Wavega-tx/Qwiic_GPS-RTK2/Hardware/Qwiic GPS-RTK2 - ublox ZED-F9P.brd

## EAGLE design Hardware/Qwiic GPS-RTK2 - ublox ZED-F9P.brd (2020-01-10)

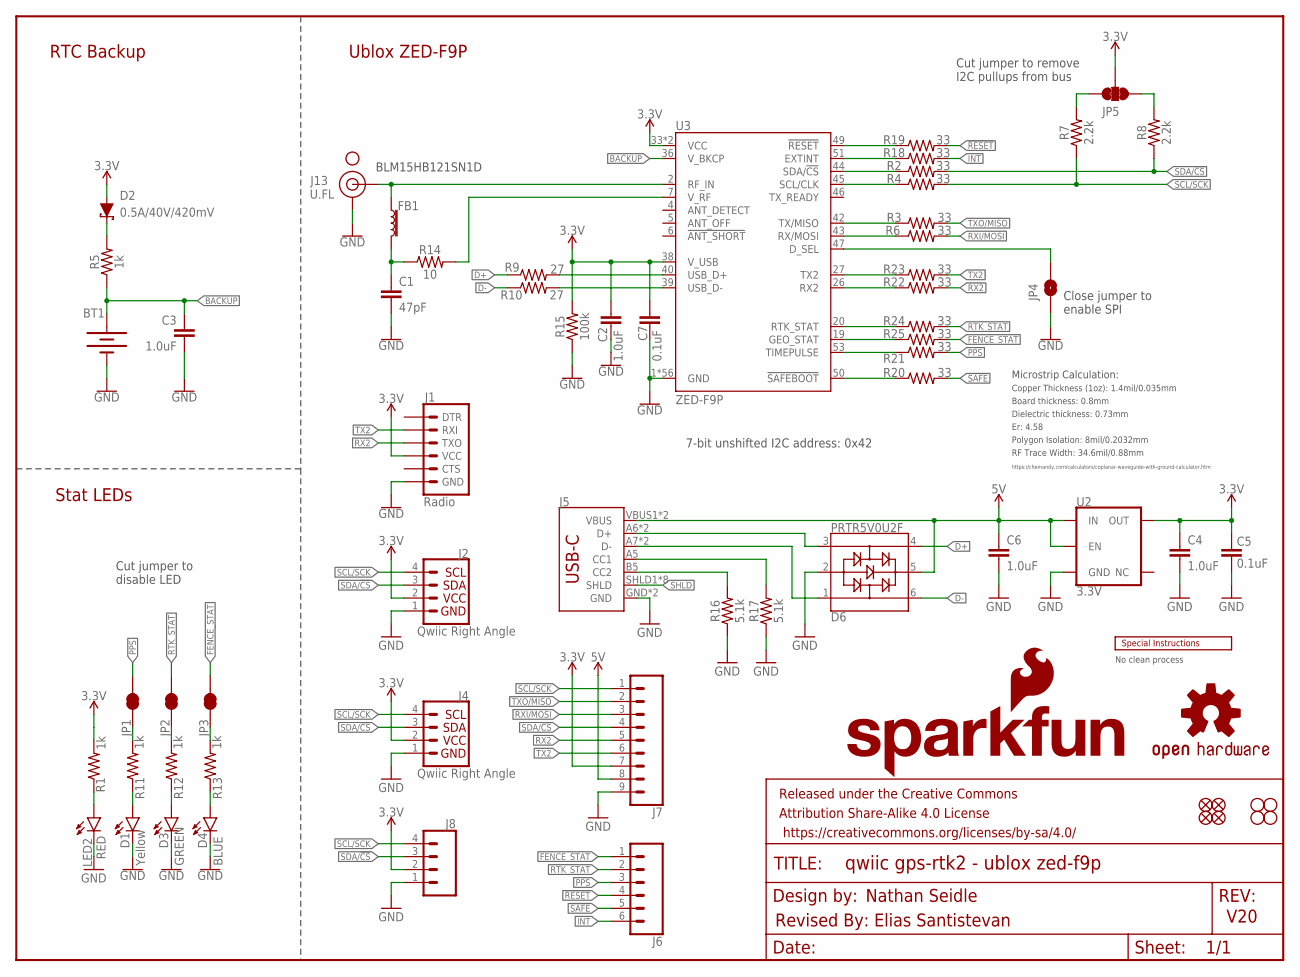
[picture p1: schematic Qwiic GPS-RTK2 - ublox ZED-F9P.sch]

Parts:
BT1: ML414H_IV01E_BATTERY; ML414H_IV01E
C1: 47pF; 0603
C2, C3, C4, C6: 1.0uF; 0603
C5, C7: 0.1uF; 0603
D1: Yellow; LED-0603
D2: 0.5A/40V/420mV; SOD-323
D3: GREEN; LED-0603
D4: BLUE; LED-0603
D6: PRTR5V0U2F; SOT886
FB1: FERRITE_BEAD-120_OHM-0402; 0402
FRAME1: FRAME-LETTER; CREATIVE_COMMONS
J1: Radio; 1X06_NO_SILK
J2, J4: Qwiic Right Angle; JST04_1MM_RA
J5: USB_C2-LAYER; USB-C-16P
J6: CONN_06NO_SILK_FEMALE_PTH; 1X06_NO_SILK
J7: CONN_09NO_SILK; 1X09_NO_SILK
J8: CONN_041X04_NO_SILK; 1X04_NO_SILK
J13: U.FL
JP1, JP2, JP3: JUMPER-SMT_2_NC_TRACE_SILK; SMT-JUMPER_2_NC_TRACE_SILK
JP4: JUMPER-SMT_2_NO_SILK; SMT-JUMPER_2_NO_SILK
JP5: JUMPER-SMT_3_2-NC_TRACE_SILK; SMT-JUMPER_3_2-NC_TRACE_SILK
JP21, JP61, JP71, JP81: FIDUCIALUFIDUCIAL; FIDUCIAL-MICRO
JP31, JP41, JP91, JP101: STAND-OFFTIGHT; STAND-OFF-TIGHT
LED2: RED; LED-0603
LOGO1: OSHW-LOGOMINI; OSHW-LOGO-MINI
LOGO2: SFE_LOGO_NAME_FLAME.1_INCH; SFE_LOGO_NAME_FLAME_.1
R1, R5, R11, R12, R13: 1k; 0603
R2, R3, R4, R6, R18, R19, R20, R21, R22, R23, R24, R25: 33; 0603
R7, R8: 2.2k; 0603
R9, R10: 27; 0603
R14: 10; 0603
R15: 100k; 0603
R16, R17: 5.1k; 0603
U2: 3.3V; SOT23-5
U3: ZED-F9P
U$2: SPECIAL_INSTRUCTIONS-ORDERING; ORDERING_INSTRUCTIONS
U$54: SMA-ANTENNA-THREADED; SMA-THREADED

Connections:
3.3V: C2.1, C4.1, C5.2, C7.2, D2.A, J1.4 (VCC), J2.2, J4.2, J7.7, J8.2, JP5.2, R1.2, R15.2, U2.5 (OUT), U3.33 (VCC), U3.34 (VCC), U3.38 (V_USB)
5V: C6.1, D6.5, J5.VBUS1 (VBUS), J5.VBUS2 (VBUS), J7.8, U2.1 (IN), U2.3 (EN)
!RESET: J6.4, R19.2
!SAFE: J6.5, R20.2
ANT_VCC: C1.1, FB1.2, R14.1
BACKUP: BT1.+, C3.1, R5.1, U3.36 (V_BKCP)
CC1: J5.A5 (CC1), R17.2
CC2: J5.B5 (CC2), R16.2
D+: D6.4, R9.1
D-: D6.6, R10.1
D_SEL: JP4.2, U3.47 (D_SEL)
FENCE_STAT: J6.1, JP3.2, R25.2
GND: BT1.-, C1.2, C2.2, C3.2, C4.2, C5.1, C6.2, C7.1, D1.C, D3.C, D4.C, D6.2, J1.6 (GND), J2.1, J4.1, J5.GND, J5.GND2 (GND), J7.9, J8.1, J13.1 (GND), J13.2 (GND), JP4.1, LED2.C, R15.1, R16.1, R17.1, U2.2 (GND), U3.1 (GND), U3.3 (GND), U3.12 (GND), U3.14 (GND), U3.32 (GND), U3.37 (GND), U3.41 (GND), U3.48 (GND), U3.55 (GND), U3.56 (GND), U3.57 (GND), U3.58 (GND), U3.59 (GND), U3.60 (GND), U3.61 (GND), U3.62 (GND), U3.63 (GND), U3.64 (GND), U3.65 (GND), U3.66 (GND), U3.67 (GND), U3.68 (GND), U3.69 (GND), U3.70 (GND), U3.71 (GND), U3.72 (GND), U3.73 (GND), U3.74 (GND), U3.75 (GND), U3.76 (GND), U3.77 (GND), U3.78 (GND), U3.79 (GND), U3.80 (GND), U3.81 (GND), U3.82 (GND), U3.83 (GND), U3.84 (GND), U3.85 (GND), U3.86 (GND), U3.87 (GND), U3.88 (GND), U3.89 (GND), U3.90 (GND), U3.91 (GND), U3.92 (GND), U3.93 (GND), U3.94 (GND), U3.95 (GND), U3.96 (GND), U3.97 (GND), U3.98 (GND), U3.99 (GND), U3.100 (GND), U3.101 (GND), U3.102 (GND)
GPS_ANT1: FB1.1, J13.FEED (SIGNAL), U3.2 (RF_IN)
INT: J6.6, R18.2
unnamed: D3.A, R12.1
unnamed: D1.A, R11.1
unnamed: JP2.1, R12.2
unnamed: JP1.1, R11.2
unnamed: JP5.1, R8.2
unnamed: D2.C, R5.2
unnamed: D4.A, R13.1
unnamed: JP5.3, R7.2
unnamed: JP3.1, R13.2
unnamed: LED2.A, R1.1
unnamed: R9.2, U3.40 (USB_D+)
unnamed: R10.2, U3.39 (USB_D-)
unnamed: R14.2, U3.7 (V_RF)
unnamed: R22.1, U3.26 (RX2)
unnamed: R18.1, U3.51 (EXTINT)
unnamed: R19.1, U3.49 (!RESET!)
unnamed: R21.1, U3.53 (TIMEPULSE)
unnamed: R20.1, U3.50 (!SAFEBOOT!)
unnamed: R24.1, U3.20 (RTK_STAT)
unnamed: R25.1, U3.19 (GEO_STAT)
PPS: J6.3, JP1.2, R21.2
RTK_STAT: J6.2, JP2.2, R24.2
RX2: J1.3 (TXO), J7.5, R22.2
RXI/MOSI: J7.3, R6.2
RXLV: R6.1, U3.43 (RX/MOSI)
SCL/SCK: J2.4, J4.4, J7.1, J8.4, R4.2, R7.1
SCL_LV: R4.1, U3.45 (SCL/CLK)
SDA/!CS: J2.3, J4.3, J7.4, J8.3, R2.2, R8.1
SDA_LV: R2.1, U3.44 (SDA/!CS!)
SHLD: J5.SHLD1 (SHLD), J5.SHLD2 (SHLD), J5.SHLD3 (SHLD), J5.SHLD4 (SHLD), J5.SHLD5 (SHLD), J5.SHLD6 (SHLD), J5.SHLD7 (SHLD), J5.SHLD8 (SHLD)
TX2: J1.2 (RXI), J7.6, R23.2
TX2_P: R23.1, U3.27 (TX2)
TXLV: R3.1, U3.42 (TX/MISO)
TXO/MISO: J7.2, R3.2
UNP_D+: D6.3, J5.A6 (D+), J5.B6 (D+)
UNP_D-: D6.1, J5.A7 (D-), J5.B7 (D-)

Notes on the sheet:
V20
7-bit unshifted I2C address: 0x42
Ublox ZED-F9P
RTC Backup
Stat LEDs
Cut jumper to remove I2C pullups from bus
Cut jumper to disable LED
Close jumper to enable SPI
BLM15HB121SN1D
Board thickness: 0.8mm
Er: 4.58
Copper Thickness (1oz): 1.4mil/0.035mm
RF Trace Width: 34.6mil/0.88mm
Polygon Isolation: 8mil/0.2032mm
No clean process
Dielectric thickness: 0.73mm
https://chemandy.com/calculators/coplanar-waveguide-with-ground-calculator.htm
Microstrip Calculation:
Nathan Seidle
Revised By: Elias Santistevan

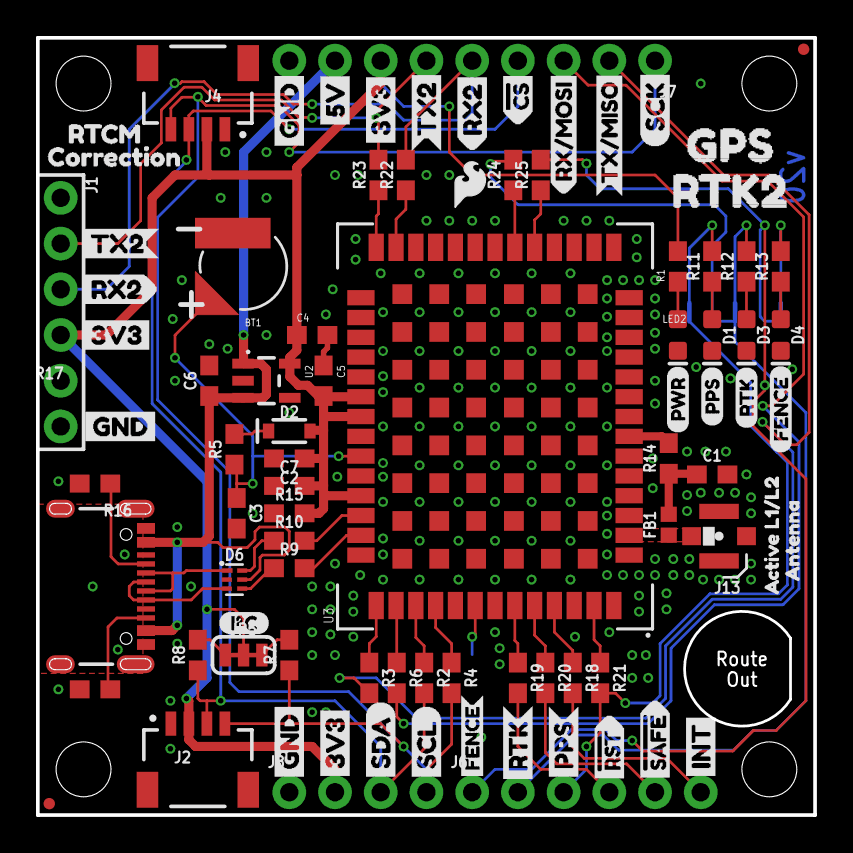
[picture p2: board Qwiic GPS-RTK2 - ublox ZED-F9P.brd from above]

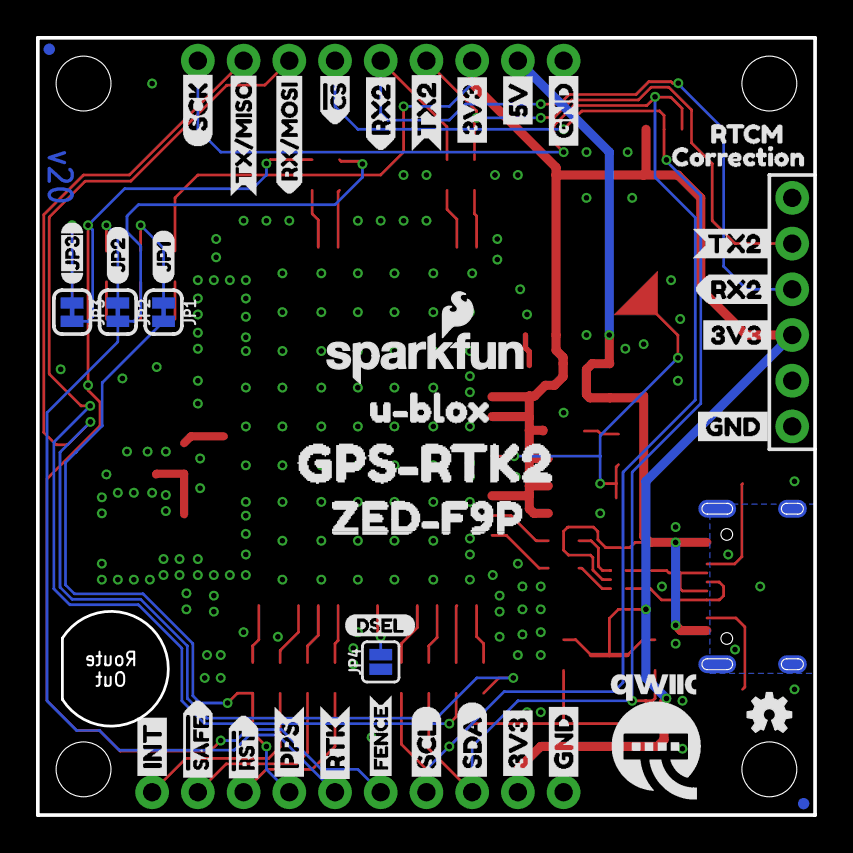
[picture p3: board Qwiic GPS-RTK2 - ublox ZED-F9P.brd from below]

Board: 2 copper layers, 43.2 x 43.2 mm, 136 parts (41 on the bottom side), 51 nets.

Other parts of the board:
U$1, U$4: SDA-[)
U$3, U$5: SCL-[)
U$6, U$7, U$60, U$61, U$66, U$67: 3V3-04
U$8, U$9, U$62, U$63: GND-04
U$10: I_SUPER2_C-()-03
U$11: FENCE2
U$12: JP20
U$13, U$28, U$29: RTK1
U$14, U$17: FENCE0
U$15, U$16: INT8
U$18: PWR-()-03
U$19, U$20: 5V
U$21, U$56, U$58: RX20
U$22: U#BLOX3
U$23, U$24: CS#-<]
U$25: JP10
U$26, U$31: RX#MOSI3
U$27: DSEL0
U$30: QWIIC-LOGO-MEDIUM
U$32: JP32
U$33: SFE_LOGO_FLAME_.1
U$34, U$37: TX#MISO1
U$35, U$36: #RST3
U$38, U$41: SCK-(]-04
U$39, U$40: #SAFE1
U$42: RX22
U$43, U$44: PPS5
U$45, U$68: GND3
U$46: GPS#RTK28
U$48, U$70: RTCM5
U$49: ZED#F9P6
U$50, U$55, U$57: TX21
U$51: TX23
U$52: PPS0
U$53, U$69: CORRECTION0
U$59: GPS0
U$64: RTK21
U$65: ACTIVE_L1#L21
U$71: ANTENNA2
