Wavega-tx/Qwiic_GPS-RTK2/Hardware/Production/Qwiic GPS-RTK2 - ublox ZED-F9P-Panel.brd

## EAGLE design Hardware/Production/Qwiic GPS-RTK2 - ublox ZED-F9P-Panel.brd (2020-01-10)

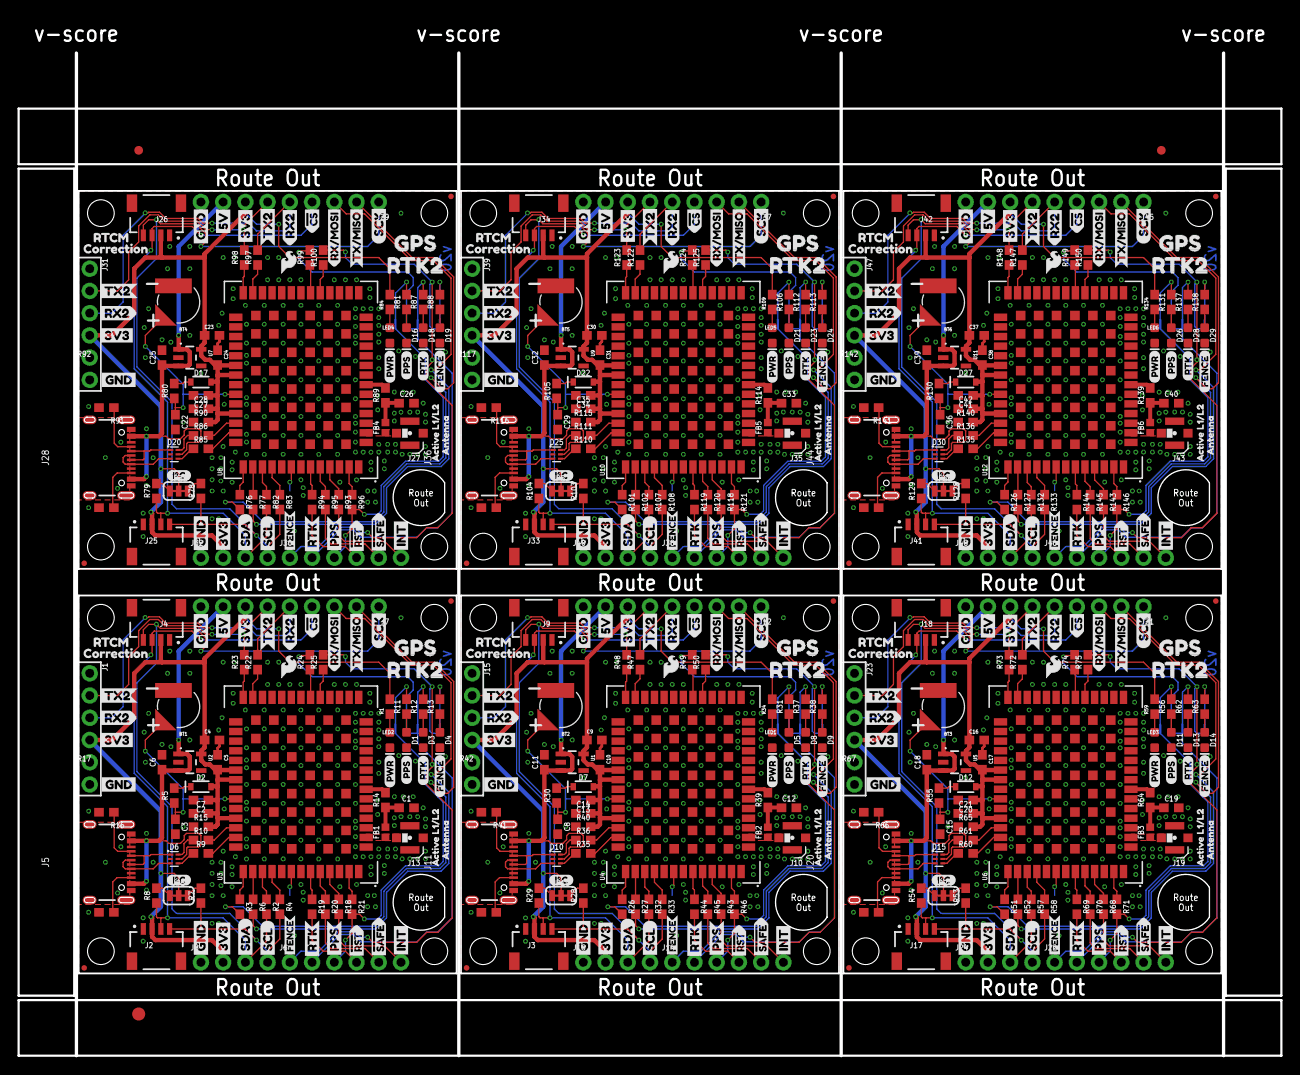
[picture p4: board Qwiic GPS-RTK2 - ublox ZED-F9P-Panel.brd from above]

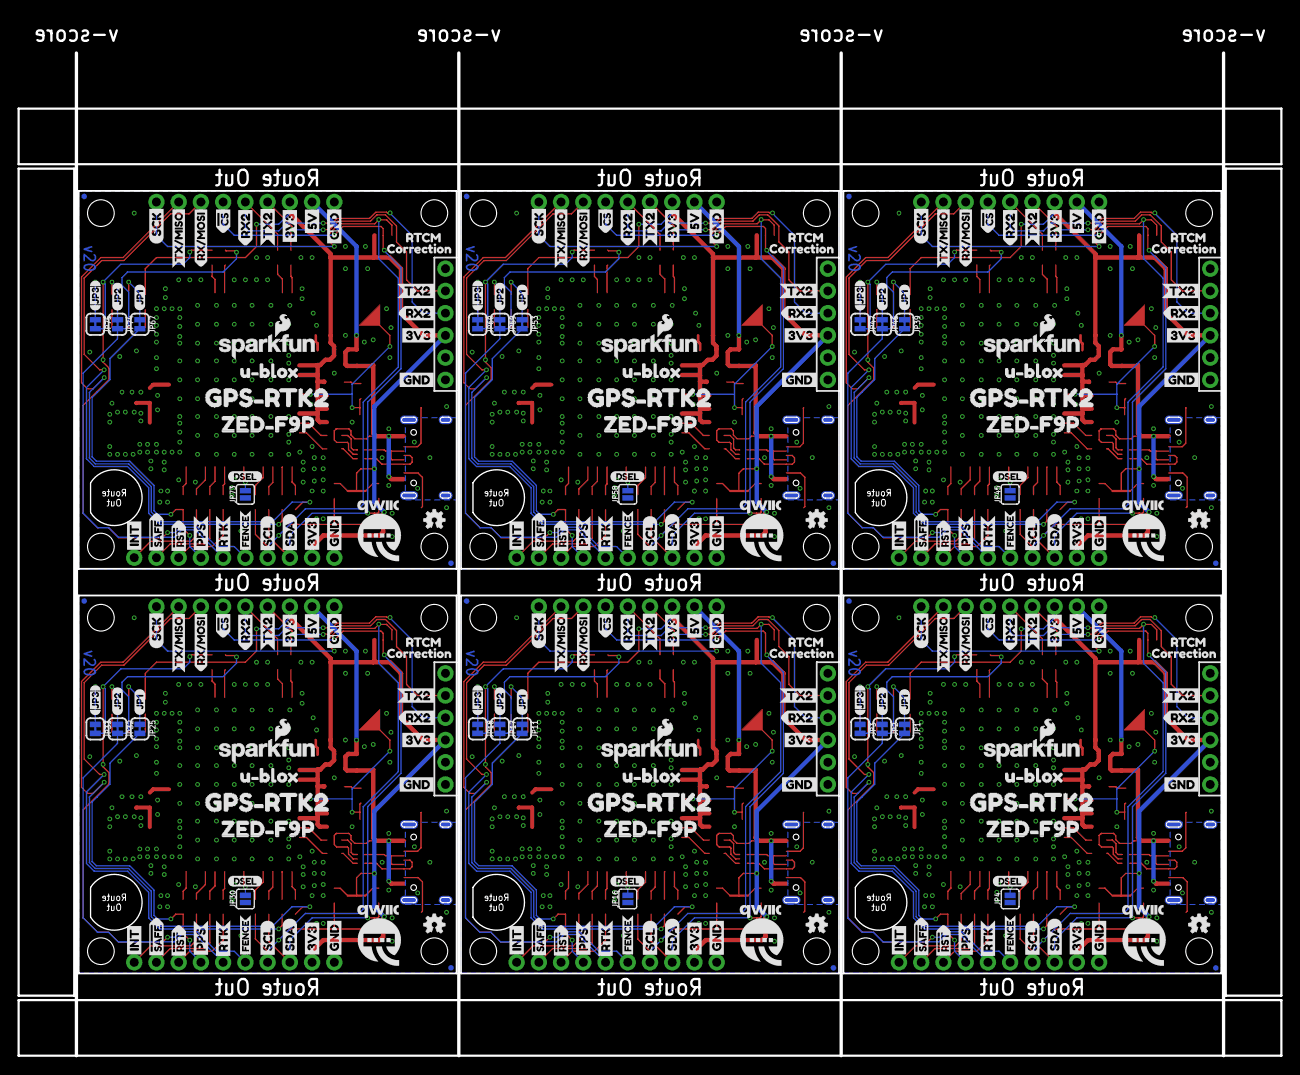
[picture p5: board Qwiic GPS-RTK2 - ublox ZED-F9P-Panel.brd from below]

Board: 2 copper layers, 144.3 x 114.6 mm, 807 parts (246 on the bottom side), 306 nets.

Parts:
BT1, BT2, BT3, BT4, BT5, BT6: ML414H_IV01E_BATTERY; ML414H_IV01E
C1, C12, C19, C26, C33, C40: 47pF; 0603
C2, C3, C4, C6, C8, C9, C11, C13, C15, C16, C18, C20, C22, C23, C25, C27, C29, C30, C32, C34, C36, C37, C39, C41: 1.0uF; 0603
C5, C7, C10, C14, C17, C21, C24, C28, C31, C35, C38, C42: 0.1uF; 0603
D1, D5, D11, D16, D21, D26: Yellow; LED-0603
D2, D7, D12, D17, D22, D27: 0.5A/40V/420mV; SOD-323
D3, D8, D13, D18, D23, D28: GREEN; LED-0603
D4, D9, D14, D19, D24, D29: BLUE; LED-0603
D6, D10, D15, D20, D25, D30: PRTR5V0U2F; SOT886
E$1, E$2: FIDUCIAL-1X2
E$3: FIDUCIAL-1.5X3
FB1, FB2, FB3, FB4, FB5, FB6: FERRITE_BEAD-120_OHM-0402; 0402
J1, J15, J23, J31, J39, J47: Radio; 1X06_NO_SILK
J2, J3, J4, J9, J17, J18, J25, J26, J33, J34, J41, J42: Qwiic Right Angle; JST04_1MM_RA
J5, J11, J20, J28, J36, J44: USB-C-16P
J6, J14, J22, J30, J38, J46: 1X06_NO_SILK
J7, J12, J21, J29, J37, J45: 1X09_NO_SILK
J8, J16, J24, J32, J40, J48: 1X04_NO_SILK
J10, J13, J19, J27, J35, J43: U.FL
JP1, JP2, JP3, JP11, JP17, JP18, JP25, JP32, JP33, JP39, JP46, JP47, JP53, JP59, JP60, JP67, JP74, JP75: JUMPER-SMT_2_NC_TRACE_SILK; SMT-JUMPER_2_NC_TRACE_SILK
JP4, JP16, JP30, JP45, JP58, JP73: JUMPER-SMT_2_NO_SILK; SMT-JUMPER_2_NO_SILK
JP5, JP10, JP24, JP38, JP52, JP66: JUMPER-SMT_3_2-NC_TRACE_SILK; SMT-JUMPER_3_2-NC_TRACE_SILK
JP6, JP7, JP14, JP15, JP19, JP20, JP28, JP29, JP31, JP34, JP35, JP41, JP43, JP44, JP48, JP49, JP56, JP57, JP62, JP63, JP70, JP72, JP91, JP101: STAND-OFFTIGHT; STAND-OFF-TIGHT
JP8, JP9, JP12, JP13, JP21, JP22, JP23, JP26, JP27, JP36, JP37, JP40, JP42, JP50, JP51, JP54, JP55, JP61, JP64, JP65, JP68, JP69, JP71, JP81: FIDUCIALUFIDUCIAL; FIDUCIAL-MICRO
LED1, LED2, LED3, LED4, LED5, LED6: RED; LED-0603
LOGO1, LOGO3, LOGO5, LOGO7, LOGO9, LOGO11: OSHW-LOGOMINI; OSHW-LOGO-MINI
LOGO2, LOGO4, LOGO6, LOGO8, LOGO10, LOGO12: SFE_LOGO_NAME_FLAME.1_INCH; SFE_LOGO_NAME_FLAME_.1
R1, R5, R11, R12, R13, R30, R31, R34, R37, R38, R55, R56, R59, R62, R63, R80, R81, R84, R87, R88, R105, R106, R109, R112, R113, R130, R131, R134, R137, R138: 1k; 0603
R2, R3, R4, R6, R18, R19, R20, R21, R22, R23, R24, R25, R26, R27, R32, R33, R43, R44, R45, R46, R47, R48, R49, R50, R51, R52, R57, R58, R68, R69, R70, R71, R72, R73, R74, R75, R76, R77, R82, R83, R93, R94, R95, R96, R97, R98, R99, R100, R101, R102, R107, R108, R118, R119, R120, R121, R122, R123, R124, R125, R126, R127, R132, R133, R143, R144, R145, R146, R147, R148, R149, R150: 33; 0603
R7, R8, R28, R29, R53, R54, R78, R79, R103, R104, R128, R129: 2.2k; 0603
R9, R10, R35, R36, R60, R61, R85, R86, R110, R111, R135, R136: 27; 0603
R14, R39, R64, R89, R114, R139: 10; 0603
R15, R40, R65, R90, R115, R140: 100k; 0603
R16, R17, R41, R42, R66, R67, R91, R92, R116, R117, R141, R142: 5.1k; 0603
U1, U2, U5, U7, U9, U11: 3.3V; SOT23-5
U3, U4, U6, U8, U10, U12: ZED-F9P
U$1, U$2, U$4, U$72, U$139, U$141, U$208, U$210, U$277, U$279, U$346, U$348: SDA-[)
U$3, U$5, U$47, U$73, U$140, U$142, U$209, U$211, U$278, U$280, U$347, U$349: SCL-[)
U$6, U$7, U$60, U$61, U$66, U$67, U$74, U$75, U$97, U$98, U$116, U$117, U$143, U$144, U$166, U$167, U$185, U$186, U$212, U$213, U$235, U$236, U$254, U$255, U$281, U$282, U$304, U$305, U$323, U$324, U$350, U$351, U$373, U$374, U$392, U$393: 3V3-04
U$8, U$9, U$62, U$63, U$76, U$77, U$99, U$100, U$145, U$146, U$168, U$169, U$214, U$215, U$237, U$238, U$283, U$284, U$306, U$307, U$352, U$353, U$375, U$376: GND-04
U$10, U$78, U$147, U$216, U$285, U$354: I_SUPER2_C-()-03
U$11, U$90, U$159, U$228, U$297, U$366: FENCE2
U$12, U$91, U$160, U$229, U$298, U$367: JP20
U$13, U$28, U$29, U$92, U$95, U$96, U$161, U$164, U$165, U$230, U$233, U$234, U$299, U$302, U$303, U$368, U$371, U$372: RTK1
U$14, U$17, U$93, U$94, U$162, U$163, U$231, U$232, U$300, U$301, U$369, U$370: FENCE0
U$15, U$16, U$79, U$80, U$148, U$149, U$217, U$218, U$286, U$287, U$355, U$356: INT8
U$18, U$104, U$173, U$242, U$311, U$380: PWR-()-03
U$19, U$20, U$105, U$106, U$174, U$175, U$243, U$244, U$312, U$313, U$381, U$382: 5V
U$21, U$56, U$58, U$129, U$134, U$136, U$198, U$203, U$205, U$267, U$272, U$274, U$336, U$341, U$343, U$405, U$410, U$412: RX20
U$22, U$81, U$150, U$219, U$288, U$357: U#BLOX3
U$23, U$24, U$107, U$108, U$176, U$177, U$245, U$246, U$314, U$315, U$383, U$384: CS#-<]
U$25, U$101, U$170, U$239, U$308, U$377: JP10
U$26, U$31, U$112, U$124, U$181, U$193, U$250, U$262, U$319, U$331, U$388, U$400: RX#MOSI3
U$27, U$103, U$172, U$241, U$310, U$379: DSEL0
U$30, U$82, U$151, U$220, U$289, U$358: QWIIC-LOGO-MEDIUM
U$32, U$102, U$171, U$240, U$309, U$378: JP32
U$33, U$111, U$180, U$249, U$318, U$387: SFE_LOGO_FLAME_.1
U$34, U$37, U$113, U$125, U$182, U$194, U$251, U$263, U$320, U$332, U$389, U$401: TX#MISO1
U$35, U$36, U$83, U$84, U$152, U$153, U$221, U$222, U$290, U$291, U$359, U$360: #RST3
U$38, U$41, U$109, U$110, U$178, U$179, U$247, U$248, U$316, U$317, U$385, U$386: SCK-(]-04
U$39, U$40, U$85, U$86, U$154, U$155, U$223, U$224, U$292, U$293, U$361, U$362: #SAFE1
U$42, U$130, U$199, U$268, U$337, U$406: RX22
U$43, U$44, U$87, U$88, U$156, U$157, U$225, U$226, U$294, U$295, U$363, U$364: PPS5
U$45, U$68, U$114, U$118, U$183, U$187, U$252, U$256, U$321, U$325, U$390, U$394: GND3
U$46, U$115, U$184, U$253, U$322, U$391: GPS#RTK28
U$48, U$70, U$120, U$122, U$189, U$191, U$258, U$260, U$327, U$329, U$396, U$398: RTCM5
U$49, U$121, U$190, U$259, U$328, U$397: ZED#F9P6
U$50, U$55, U$57, U$131, U$133, U$135, U$200, U$202, U$204, U$269, U$271, U$273, U$338, U$340, U$342, U$407, U$409, U$411: TX21
U$51, U$132, U$201, U$270, U$339, U$408: TX23
U$52, U$89, U$158, U$227, U$296, U$365: PPS0
U$53, U$69, U$119, U$123, U$188, U$192, U$257, U$261, U$326, U$330, U$395, U$399: CORRECTION0
U$54, U$126, U$195, U$264, U$333, U$402: SMA-ANTENNA-THREADED; SMA-THREADED
U$59, U$137, U$206, U$275, U$344, U$413: GPS0
U$64, U$138, U$207, U$276, U$345, U$414: RTK21
U$65, U$127, U$196, U$265, U$334, U$403: ACTIVE_L1#L21
U$71, U$128, U$197, U$266, U$335, U$404: ANTENNA2

Connections:
3.3V: C2.1, C4.1, C5.2, C7.2, D2.A, J1.4, J2.2, J4.2, J7.7, J8.2, JP5.2, R1.2, R15.2, U2.5, U3.33, U3.34, U3.38
3.3V1: C9.1, C10.2, C13.1, C14.2, D7.A, J3.2, J9.2, J12.7, J15.4, J16.2, JP10.2, R34.2, R40.2, U1.5, U4.33, U4.34, U4.38
3.3V2: C16.1, C17.2, C20.1, C21.2, D12.A, J17.2, J18.2, J21.7, J23.4, J24.2, JP24.2, R59.2, R65.2, U5.5, U6.33, U6.34, U6.38
3.3V3: C23.1, C24.2, C27.1, C28.2, D17.A, J25.2, J26.2, J29.7, J31.4, J32.2, JP38.2, R84.2, R90.2, U7.5, U8.33, U8.34, U8.38
3.3V4: C30.1, C31.2, C34.1, C35.2, D22.A, J33.2, J34.2, J37.7, J39.4, J40.2, JP52.2, R109.2, R115.2, U9.5, U10.33, U10.34, U10.38
3.3V5: C37.1, C38.2, C41.1, C42.2, D27.A, J41.2, J42.2, J45.7, J47.4, J48.2, JP66.2, R134.2, R140.2, U11.5, U12.33, U12.34, U12.38
5V: C6.1, D6.5, J5.VBUS1, J5.VBUS2, J7.8, U2.1, U2.3
5V1: C11.1, D10.5, J11.VBUS1, J11.VBUS2, J12.8, U1.1, U1.3
5V2: C18.1, D15.5, J20.VBUS1, J20.VBUS2, J21.8, U5.1, U5.3
5V3: C25.1, D20.5, J28.VBUS1, J28.VBUS2, J29.8, U7.1, U7.3
5V4: C32.1, D25.5, J36.VBUS1, J36.VBUS2, J37.8, U9.1, U9.3
5V5: C39.1, D30.5, J44.VBUS1, J44.VBUS2, J45.8, U11.1, U11.3
!RESET: J6.4, R19.2
!RESET1: J14.4, R44.2
!RESET2: J22.4, R69.2
!RESET3: J30.4, R94.2
!RESET4: J38.4, R119.2
!RESET5: J46.4, R144.2
!SAFE: J6.5, R20.2
!SAFE1: J14.5, R45.2
!SAFE2: J22.5, R70.2
!SAFE3: J30.5, R95.2
!SAFE4: J38.5, R120.2
!SAFE5: J46.5, R145.2
ANT_VCC: C1.1, FB1.2, R14.1
ANT_VCC1: C12.1, FB2.2, R39.1
ANT_VCC2: C19.1, FB3.2, R64.1
ANT_VCC3: C26.1, FB4.2, R89.1
ANT_VCC4: C33.1, FB5.2, R114.1
ANT_VCC5: C40.1, FB6.2, R139.1
BACKUP: BT1.+, C3.1, R5.1, U3.36
BACKUP1: BT2.+, C8.1, R30.1, U4.36
BACKUP2: BT3.+, C15.1, R55.1, U6.36
BACKUP3: BT4.+, C22.1, R80.1, U8.36
BACKUP4: BT5.+, C29.1, R105.1, U10.36
BACKUP5: BT6.+, C36.1, R130.1, U12.36
CC1: J5.A5, R17.2
CC2: J5.B5, R16.2
CC3: J11.A5, R42.2
CC4: J11.B5, R41.2
CC5: J20.A5, R67.2
CC6: J20.B5, R66.2
CC7: J28.A5, R92.2
CC8: J28.B5, R91.2
CC9: J36.A5, R117.2
CC10: J36.B5, R116.2
CC11: J44.A5, R142.2
CC12: J44.B5, R141.2
D+: D6.4, R9.1
D+1: D10.4, R35.1
D+2: D15.4, R60.1
D+3: D20.4, R85.1
D+4: D25.4, R110.1
D+5: D30.4, R135.1
D-: D6.6, R10.1
D-1: D10.6, R36.1
D-2: D15.6, R61.1
D-3: D20.6, R86.1
D-4: D25.6, R111.1
D-5: D30.6, R136.1
D_SEL: JP4.2, U3.47
D_SEL1: JP16.2, U4.47
D_SEL2: JP30.2, U6.47
D_SEL3: JP45.2, U8.47
D_SEL4: JP58.2, U10.47
D_SEL5: JP73.2, U12.47
FENCE_STAT: J6.1, JP3.2, R25.2
FENCE_STAT1: J14.1, JP18.2, R50.2
FENCE_STAT2: J22.1, JP33.2, R75.2
FENCE_STAT3: J30.1, JP47.2, R100.2
FENCE_STAT4: J38.1, JP60.2, R125.2
FENCE_STAT5: J46.1, JP75.2, R150.2
GND: BT1.-, C1.2, C2.2, C3.2, C4.2, C5.1, C6.2, C7.1, D1.C, D3.C, D4.C, D6.2, J1.6, J2.1, J4.1, J5.GND, J5.GND2, J7.9, J8.1, J13.1, J13.2, JP4.1, LED2.C, R15.1, R16.1, R17.1, U2.2, U3.1, U3.3, U3.12, U3.14, U3.32, U3.37, U3.41, U3.48, U3.55, U3.56, U3.57, U3.58, U3.59, U3.60, U3.61, U3.62, U3.63, U3.64, U3.65, U3.66, U3.67, U3.68, U3.69, U3.70, U3.71, U3.72, U3.73, U3.74, U3.75, U3.76, U3.77, U3.78, U3.79, U3.80, U3.81, U3.82, U3.83, U3.84, U3.85, U3.86, U3.87, U3.88, U3.89, U3.90, U3.91, U3.92, U3.93, U3.94, U3.95, U3.96, U3.97, U3.98, U3.99, U3.100, U3.101, U3.102
GND1: BT2.-, C8.2, C9.2, C10.1, C11.2, C12.2, C13.2, C14.1, D5.C, D8.C, D9.C, D10.2, J3.1, J9.1, J10.1, J10.2, J11.GND, J11.GND2, J12.9, J15.6, J16.1, JP16.1, LED1.C, R40.1, R41.1, R42.1, U1.2, U4.1, U4.3, U4.12, U4.14, U4.32, U4.37, U4.41, U4.48, U4.55, U4.56, U4.57, U4.58, U4.59, U4.60, U4.61, U4.62, U4.63, U4.64, U4.65, U4.66, U4.67, U4.68, U4.69, U4.70, U4.71, U4.72, U4.73, U4.74, U4.75, U4.76, U4.77, U4.78, U4.79, U4.80, U4.81, U4.82, U4.83, U4.84, U4.85, U4.86, U4.87, U4.88, U4.89, U4.90, U4.91, U4.92, U4.93, U4.94, U4.95, U4.96, U4.97, U4.98, U4.99, U4.100, U4.101, U4.102
GND2: BT3.-, C15.2, C16.2, C17.1, C18.2, C19.2, C20.2, C21.1, D11.C, D13.C, D14.C, D15.2, J17.1, J18.1, J19.1, J19.2, J20.GND, J20.GND2, J21.9, J23.6, J24.1, JP30.1, LED3.C, R65.1, R66.1, R67.1, U5.2, U6.1, U6.3, U6.12, U6.14, U6.32, U6.37, U6.41, U6.48, U6.55, U6.56, U6.57, U6.58, U6.59, U6.60, U6.61, U6.62, U6.63, U6.64, U6.65, U6.66, U6.67, U6.68, U6.69, U6.70, U6.71, U6.72, U6.73, U6.74, U6.75, U6.76, U6.77, U6.78, U6.79, U6.80, U6.81, U6.82, U6.83, U6.84, U6.85, U6.86, U6.87, U6.88, U6.89, U6.90, U6.91, U6.92, U6.93, U6.94, U6.95, U6.96, U6.97, U6.98, U6.99, U6.100, U6.101, U6.102
GND3: BT4.-, C22.2, C23.2, C24.1, C25.2, C26.2, C27.2, C28.1, D16.C, D18.C, D19.C, D20.2, J25.1, J26.1, J27.1, J27.2, J28.GND, J28.GND2, J29.9, J31.6, J32.1, JP45.1, LED4.C, R90.1, R91.1, R92.1, U7.2, U8.1, U8.3, U8.12, U8.14, U8.32, U8.37, U8.41, U8.48, U8.55, U8.56, U8.57, U8.58, U8.59, U8.60, U8.61, U8.62, U8.63, U8.64, U8.65, U8.66, U8.67, U8.68, U8.69, U8.70, U8.71, U8.72, U8.73, U8.74, U8.75, U8.76, U8.77, U8.78, U8.79, U8.80, U8.81, U8.82, U8.83, U8.84, U8.85, U8.86, U8.87, U8.88, U8.89, U8.90, U8.91, U8.92, U8.93, U8.94, U8.95, U8.96, U8.97, U8.98, U8.99, U8.100, U8.101, U8.102
GND4: BT5.-, C29.2, C30.2, C31.1, C32.2, C33.2, C34.2, C35.1, D21.C, D23.C, D24.C, D25.2, J33.1, J34.1, J35.1, J35.2, J36.GND, J36.GND2, J37.9, J39.6, J40.1, JP58.1, LED5.C, R115.1, R116.1, R117.1, U9.2, U10.1, U10.3, U10.12, U10.14, U10.32, U10.37, U10.41, U10.48, U10.55, U10.56, U10.57, U10.58, U10.59, U10.60, U10.61, U10.62, U10.63, U10.64, U10.65, U10.66, U10.67, U10.68, U10.69, U10.70, U10.71, U10.72, U10.73, U10.74, U10.75, U10.76, U10.77, U10.78, U10.79, U10.80, U10.81, U10.82, U10.83, U10.84, U10.85, U10.86, U10.87, U10.88, U10.89, U10.90, U10.91, U10.92, U10.93, U10.94, U10.95, U10.96, U10.97, U10.98, U10.99, U10.100, U10.101, U10.102
GND5: BT6.-, C36.2, C37.2, C38.1, C39.2, C40.2, C41.2, C42.1, D26.C, D28.C, D29.C, D30.2, J41.1, J42.1, J43.1, J43.2, J44.GND, J44.GND2, J45.9, J47.6, J48.1, JP73.1, LED6.C, R140.1, R141.1, R142.1, U11.2, U12.1, U12.3, U12.12, U12.14, U12.32, U12.37, U12.41, U12.48, U12.55, U12.56, U12.57, U12.58, U12.59, U12.60, U12.61, U12.62, U12.63, U12.64, U12.65, U12.66, U12.67, U12.68, U12.69, U12.70, U12.71, U12.72, U12.73, U12.74, U12.75, U12.76, U12.77, U12.78, U12.79, U12.80, U12.81, U12.82, U12.83, U12.84, U12.85, U12.86, U12.87, U12.88, U12.89, U12.90, U12.91, U12.92, U12.93, U12.94, U12.95, U12.96, U12.97, U12.98, U12.99, U12.100, U12.101, U12.102
GPS_ANT1: FB1.1, J13.FEED, U3.2
GPS_ANT2: FB2.1, J10.FEED, U4.2
GPS_ANT3: FB3.1, J19.FEED, U6.2
GPS_ANT4: FB4.1, J27.FEED, U8.2
GPS_ANT5: FB5.1, J35.FEED, U10.2
GPS_ANT6: FB6.1, J43.FEED, U12.2
INT: J6.6, R18.2
INT1: J14.6, R43.2
INT2: J22.6, R68.2
INT3: J30.6, R93.2
INT4: J38.6, R118.2
INT5: J46.6, R143.2
unnamed: D3.A, R12.1
unnamed: D1.A, R11.1
unnamed: JP2.1, R12.2
unnamed: JP1.1, R11.2
unnamed: JP5.1, R8.2
unnamed: D2.C, R5.2
unnamed: D4.A, R13.1
unnamed: JP5.3, R7.2
unnamed: JP3.1, R13.2
unnamed: LED2.A, R1.1
unnamed: R9.2, U3.40
unnamed: R10.2, U3.39
unnamed: R14.2, U3.7
unnamed: R22.1, U3.26
unnamed: R18.1, U3.51
unnamed: R19.1, U3.49
unnamed: R21.1, U3.53
unnamed: R20.1, U3.50
unnamed: R24.1, U3.20
unnamed: R25.1, U3.19
unnamed: JP10.1, R29.2
unnamed: JP10.3, R28.2
unnamed: D5.A, R31.1
unnamed: JP11.1, R31.2
unnamed: D7.C, R30.2
unnamed: LED1.A, R34.1
unnamed: R35.2, U4.40
unnamed: R36.2, U4.39
unnamed: D8.A, R37.1
unnamed: JP17.1, R37.2
unnamed: D9.A, R38.1
unnamed: JP18.1, R38.2
unnamed: R39.2, U4.7
unnamed: R47.1, U4.26
unnamed: R43.1, U4.51
unnamed: R44.1, U4.49
unnamed: R46.1, U4.53
unnamed: R45.1, U4.50
unnamed: R49.1, U4.20
unnamed: R50.1, U4.19
unnamed: JP24.1, R54.2
unnamed: JP24.3, R53.2
unnamed: D11.A, R56.1
unnamed: JP25.1, R56.2
unnamed: D12.C, R55.2
unnamed: LED3.A, R59.1
unnamed: R60.2, U6.40
unnamed: R61.2, U6.39
unnamed: D13.A, R62.1
unnamed: JP32.1, R62.2
unnamed: D14.A, R63.1
unnamed: JP33.1, R63.2
unnamed: R64.2, U6.7
unnamed: R72.1, U6.26
unnamed: R68.1, U6.51
unnamed: R69.1, U6.49
unnamed: R71.1, U6.53
unnamed: R70.1, U6.50
unnamed: R74.1, U6.20
unnamed: R75.1, U6.19
unnamed: JP38.1, R79.2
unnamed: JP38.3, R78.2
unnamed: D16.A, R81.1
unnamed: JP39.1, R81.2
unnamed: D17.C, R80.2
unnamed: LED4.A, R84.1
unnamed: R85.2, U8.40
unnamed: R86.2, U8.39
unnamed: D18.A, R87.1
unnamed: JP46.1, R87.2
unnamed: D19.A, R88.1
unnamed: JP47.1, R88.2
unnamed: R89.2, U8.7
unnamed: R97.1, U8.26
unnamed: R93.1, U8.51
unnamed: R94.1, U8.49
unnamed: R96.1, U8.53
unnamed: R95.1, U8.50
unnamed: R99.1, U8.20
unnamed: R100.1, U8.19
unnamed: JP52.1, R104.2
unnamed: JP52.3, R103.2
unnamed: D21.A, R106.1
unnamed: JP53.1, R106.2
unnamed: D22.C, R105.2
unnamed: LED5.A, R109.1
unnamed: R110.2, U10.40
unnamed: R111.2, U10.39
unnamed: D23.A, R112.1
unnamed: JP59.1, R112.2
unnamed: D24.A, R113.1
unnamed: JP60.1, R113.2
unnamed: R114.2, U10.7
unnamed: R122.1, U10.26
unnamed: R118.1, U10.51
unnamed: R119.1, U10.49
unnamed: R121.1, U10.53
unnamed: R120.1, U10.50
unnamed: R124.1, U10.20
unnamed: R125.1, U10.19
unnamed: JP66.1, R129.2
unnamed: JP66.3, R128.2
unnamed: D26.A, R131.1
unnamed: JP67.1, R131.2
unnamed: D27.C, R130.2
unnamed: LED6.A, R134.1
unnamed: R135.2, U12.40
unnamed: R136.2, U12.39
unnamed: D28.A, R137.1
unnamed: JP74.1, R137.2
unnamed: D29.A, R138.1
unnamed: JP75.1, R138.2
unnamed: R139.2, U12.7
unnamed: R147.1, U12.26
unnamed: R143.1, U12.51
unnamed: R144.1, U12.49
unnamed: R146.1, U12.53
unnamed: R145.1, U12.50
unnamed: R149.1, U12.20
unnamed: R150.1, U12.19
PPS: J6.3, JP1.2, R21.2
PPS1: J14.3, JP11.2, R46.2
PPS2: J22.3, JP25.2, R71.2
PPS3: J30.3, JP39.2, R96.2
PPS4: J38.3, JP53.2, R121.2
PPS5: J46.3, JP67.2, R146.2
RTK_STAT: J6.2, JP2.2, R24.2
RTK_STAT1: J14.2, JP17.2, R49.2
RTK_STAT2: J22.2, JP32.2, R74.2
RTK_STAT3: J30.2, JP46.2, R99.2
RTK_STAT4: J38.2, JP59.2, R124.2
RTK_STAT5: J46.2, JP74.2, R149.2
RX1: J12.5, J15.3, R47.2
RX2: J1.3, J7.5, R22.2
RX3: J21.5, J23.3, R72.2
RX4: J29.5, J31.3, R97.2
RX5: J37.5, J39.3, R122.2
RX6: J45.5, J47.3, R147.2
RXI/MOSI: J7.3, R6.2
RXI/MOSI1: J12.3, R27.2
RXI/MOSI2: J21.3, R52.2
RXI/MOSI3: J29.3, R77.2
RXI/MOSI4: J37.3, R102.2
RXI/MOSI5: J45.3, R127.2
RXLV: R6.1, U3.43
RXLV1: R27.1, U4.43
RXLV2: R52.1, U6.43
RXLV3: R77.1, U8.43
RXLV4: R102.1, U10.43
RXLV5: R127.1, U12.43
SCL/SCK: J2.4, J4.4, J7.1, J8.4, R4.2, R7.1
SCL/SCK1: J3.4, J9.4, J12.1, J16.4, R28.1, R33.2
SCL/SCK2: J17.4, J18.4, J21.1, J24.4, R53.1, R58.2
SCL/SCK3: J25.4, J26.4, J29.1, J32.4, R78.1, R83.2
SCL/SCK4: J33.4, J34.4, J37.1, J40.4, R103.1, R108.2
SCL/SCK5: J41.4, J42.4, J45.1, J48.4, R128.1, R133.2
SCL_LV: R4.1, U3.45
SCL_LV1: R33.1, U4.45
SCL_LV2: R58.1, U6.45
SCL_LV3: R83.1, U8.45
SCL_LV4: R108.1, U10.45
SCL_LV5: R133.1, U12.45
SDA/!CS: J2.3, J4.3, J7.4, J8.3, R2.2, R8.1
SDA/!CS1: J3.3, J9.3, J12.4, J16.3, R29.1, R32.2
SDA/!CS2: J17.3, J18.3, J21.4, J24.3, R54.1, R57.2
SDA/!CS3: J25.3, J26.3, J29.4, J32.3, R79.1, R82.2
SDA/!CS4: J33.3, J34.3, J37.4, J40.3, R104.1, R107.2
SDA/!CS5: J41.3, J42.3, J45.4, J48.3, R129.1, R132.2
SDA_LV: R2.1, U3.44
SDA_LV1: R32.1, U4.44
SDA_LV2: R57.1, U6.44
SDA_LV3: R82.1, U8.44
SDA_LV4: R107.1, U10.44
SDA_LV5: R132.1, U12.44
SHLD: J5.SHLD1, J5.SHLD2, J5.SHLD3, J5.SHLD4, J5.SHLD5, J5.SHLD6, J5.SHLD7, J5.SHLD8
SHLD1: J11.SHLD1, J11.SHLD2, J11.SHLD3, J11.SHLD4, J11.SHLD5, J11.SHLD6, J11.SHLD7, J11.SHLD8
SHLD2: J20.SHLD1, J20.SHLD2, J20.SHLD3, J20.SHLD4, J20.SHLD5, J20.SHLD6, J20.SHLD7, J20.SHLD8
SHLD3: J28.SHLD1, J28.SHLD2, J28.SHLD3, J28.SHLD4, J28.SHLD5, J28.SHLD6, J28.SHLD7, J28.SHLD8
SHLD4: J36.SHLD1, J36.SHLD2, J36.SHLD3, J36.SHLD4, J36.SHLD5, J36.SHLD6, J36.SHLD7, J36.SHLD8
SHLD5: J44.SHLD1, J44.SHLD2, J44.SHLD3, J44.SHLD4, J44.SHLD5, J44.SHLD6, J44.SHLD7, J44.SHLD8
TX1: J12.6, J15.2, R48.2
TX2: J1.2, J7.6, R23.2
TX2_P: R23.1, U3.27
TX2_P1: R48.1, U4.27
TX2_P2: R73.1, U6.27
TX2_P3: R98.1, U8.27
TX2_P4: R123.1, U10.27
TX2_P5: R148.1, U12.27
TX3: J21.6, J23.2, R73.2
TX4: J29.6, J31.2, R98.2
TX5: J37.6, J39.2, R123.2
TX6: J45.6, J47.2, R148.2
TXLV: R3.1, U3.42
TXLV1: R26.1, U4.42
TXLV2: R51.1, U6.42
TXLV3: R76.1, U8.42
TXLV4: R101.1, U10.42
TXLV5: R126.1, U12.42
TXO/MISO: J7.2, R3.2
TXO/MISO1: J12.2, R26.2
TXO/MISO2: J21.2, R51.2
TXO/MISO3: J29.2, R76.2
TXO/MISO4: J37.2, R101.2
TXO/MISO5: J45.2, R126.2
UNP_D+: D6.3, J5.A6, J5.B6
UNP_D+1: D10.3, J11.A6, J11.B6
UNP_D+2: D15.3, J20.A6, J20.B6
UNP_D+3: D20.3, J28.A6, J28.B6
UNP_D+4: D25.3, J36.A6, J36.B6
UNP_D+5: D30.3, J44.A6, J44.B6
UNP_D-: D6.1, J5.A7, J5.B7
UNP_D-1: D10.1, J11.A7, J11.B7
UNP_D-2: D15.1, J20.A7, J20.B7
UNP_D-3: D20.1, J28.A7, J28.B7
UNP_D-4: D25.1, J36.A7, J36.B7
UNP_D-5: D30.1, J44.A7, J44.B7
