Wavega-tx/Qwiic_GPS-RTK2/(commit log)

2020-01-10 Adds reflowable battery and uses all parts from SparkFun Libraries
    [Qwiic GPS-RTK2 - ublox ZED-F9P.brd, Qwiic GPS-RTK2 - ublox ZED-F9P.sch]
2020-01-10 Adds panel for v20
    [Qwiic GPS-RTK2 - ublox ZED-F9P-Panel.GBL, Qwiic GPS-RTK2 - ublox ZED-F9P-Panel.GBO, Qwiic GPS-RTK2 - ublox ZED-F9P-Panel.GBS, Qwiic GPS-RTK2 - ublox ZED-F9P-Panel.GKO, Qwiic GPS-RTK2 - ublox ZED-F9P-Panel.GTL, Qwiic GPS-RTK2 - ublox ZED-F9P-Panel.GTO, Qwiic GPS-RTK2 - ublox ZED-F9P-Panel.GTP, Qwiic GPS-RTK2 - ublox ZED-F9P-Panel.GTS]
